kennethgrau/CAST_BACKUP/README.md

# CAST_BACKUP
This is a proper backup for the CAST capstone repository created by the software guys.

This repository contains software (C++ & Python) and hardware design files for the CAST Project.

### Visit the [CAST Google Drive](https://drive.google.com/drive/folders/1zKrm8BXflb28vrKOYb7QlBGXoKk1sI_n?usp=sharing)
## Cast Robot:
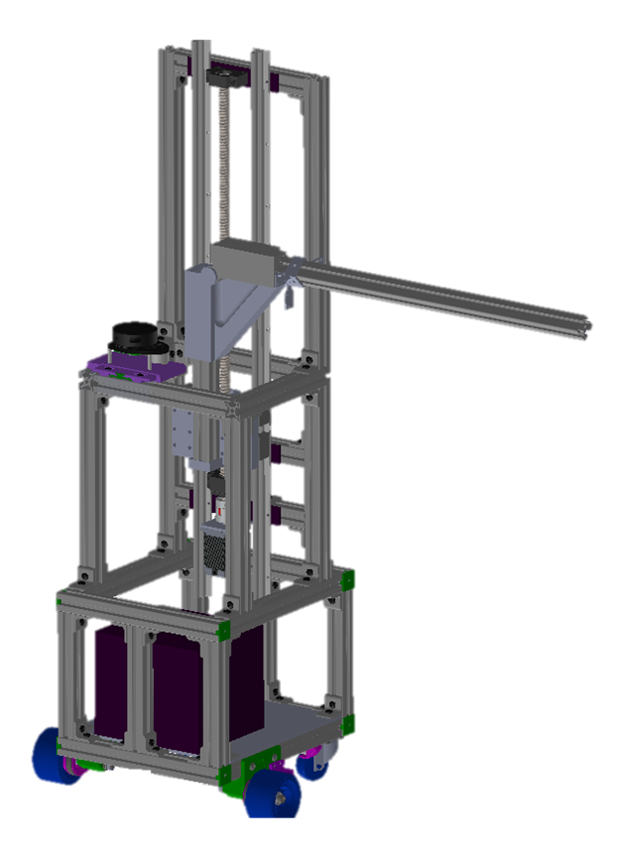
[picture p1: docs/photos&videos/index_files/Picture1.png]
CAST Robot


## Executive Summary
Our covid sanitization robot will bridge the gap between the need for clean surfaces and the lack of workforce brought about by different circumstances. Our robot will utilize a gamepad controller to move and Lidar as an early warning system of moving obstacles. To sanitize surfaces, we have a robotic arm equipped with UV lights that kill bacteria upon exposure and three time of flight sensors that will take in proximity data and maintain a safe distance between the arm and the surface to be cleaned. 

To allow the user to test the effectiveness of the robot we are also creating a bacteria killed indicator. This indicator uses a UV sensor to measure the amount of UV C radiation absorbed by the area and has the capabilities to communicate using IOT. By incorporating this product, we are giving the user an ability to test the effectiveness of the robot, this will be useful for error detection. 

By incorporating lidar into our design we’re paving the way for the robot to be fully autonomous in the future, removing the need for the gamepad controller. With a fully autonomous robot the design will be able to clean a small area without human interaction.

## Special Thanks
The team would like to start off by thanking everyone that has helped us get to this point in our project. Specifically, Dr. Biswas, David Malawey, Donald Bowen, Brey Carawey, Jorge Roa, Ricardo Castillo, Matthew Hammond, and Dr. Crosby. We’d also like to extend our thanks to the Texas A&M ETID department for the time and funding put into ensuring we had all the resources we needed to complete this project.

## License
This work is licensed under the Creative Commons Attribution-ShareAlike 4.0 License. To view details visit [creativecommons.org](https://creativecommons.org/licenses/by-sa/4.0/legalcode)
