kennethgrau/CAST_BACKUP/hardware/README.md

# CAST Hardware
This directory contains zipped gerber files, CAD models, and other hardware information.

### More hardware information can be found [here](https://drive.google.com/drive/folders/1Sd6P2nbnLkVIloje-kZ2ATfiy8y1uPqs?usp=sharing).
