kennethgrau/CAST_BACKUP/docs/supplemental/CAST BillofMaterials.pdf

# Project System | Item Name | Item Description | Source | Datasheet | Quantity | Unit | Price | Cost | Notes | PO | Approval | Fulfilled | Total | Budget remaining

1 Movement | SCUTTLE | SCUTTLE Robot Kit v2.3 | https://scuttlerobot.org/https://scuttlerobot.org/resources 1 | | | ea | $519.99 | $519.99 | | | DM | Yes | $3,063.94 | $1,936
2 | Movement | RPLidar A1M8 | RPLidar A1M8 (Changed from RPLidar s2) | https://www.adafruit.com/product/4010 https://cdn-shop.adafruit.com/product-files/4010/4010_datasheet.pdf 1 | ea | $99.95 | $99.95 | DM | Yes 3 | Movement | LifePO Battery | Ampere Time 12V 50Ah LiFePO4 Battery with 14.6V 10A Dedicated Lithium Battery Charger; Built-in 50A BMS, 4000+ Cycles, for Bass Boats, Trolling Motors, Monitoring Device, RV, Solar application… https://www.amazon.com/Ampere-Time-Dedicated-Monitoring-application/dp/B09DYTRYQL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 1 | ea | $314.99 | $314.99 | Yes | Totals 5 | Movement | USB A to Micro-B | USB Cable for connecting Lidar to Raspberry Pi | https://www.amazon.com/AmazonBasics-Male-Micro-Cable-Black/dp/B07232M876?th=1 1 | ea | $5.71 | $5.71 | DM | Yes | Budget | $5,000
6 | Infrastructure | T-Slotted Framing Rails | Size - T-Slotted Framing Rails | https://www.mcmaster.com/metals/structural-framing/t-slotted-framing-rails/ 40 | ft | $8.00 | $320.00 | Estimated | -please use automationdirect.com for better price 7 | Infrastructure | T-Slotted Corner Bracket | T-Slotted Corner Bracket for Single Rails (fasteners included) | https://www.mcmaster.com/80%2F20-compatible-t-slotted-framing/t-slotted-framing-structural-brackets/ 75 | ea | $3.40 | $255.00 | Estimated (find these on amazon for better value) | please match SCTL brackets & buy necessary fasteners, or 3D Print if you need a larger bracket 8 | Sanitizing Arm | T-Slotted Framing Rails | Size - T-Slotted Framing Rails | https://www.mcmaster.com/metals/structural-framing/t-slotted-framing-rails/ 2 | ft | $8.00 | $16.00 | please use automationdirect | Yes 9 | Sanitizing Arm | UV Diode (Old Diode) | L944-UV265-3 | https://www.digikey.com/en/products/detail/american-opto-plus-led/L944-UV265-3/12088431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 https://www.aopled.com/AOP_PDFs/L944-UV265-3.pdf 0 | ea | $25.00 | $0.00 | Already have | DM | Yes 10 | Sanitizing Arm | UV Diode (New Diode) | IN-C40PU(X)TK UVC | https://www.mouser.com/ProductDetail/Inolux/IN-C40PUBTKU1?qs=zW32dvEIR3sNPH03MBtbqA%3D%3D https://www.mouser.com/datasheet/2/180/IN_C40PU_X_TK_UVC_Series_V1_0-1919562.pdf 20 | ea | $25.67 | $513.40 | DM | Yes 11 | Sanitizing Arm | SM Relay Hat | Relay Hat to control UV lights | SM Relay HAT | 1 | ea | $45.00 | $45 | No longer considering | This relay hat will block airflow to your processor, also relays are much cheaper. 12 | Sanitizing Arm | NOYITO SSR Relay | 2 channel, 12V SSR relay to control UV lights | NOYITO Relay | 1 | ea | $8.50 | $8.50
13 | Sanitizing Arm | SSR-25DD | DC to DC Relay | SSR-25DD (https://www.amazon.com/SSR-100DD-3-32VDC-Output-5-240VDC-Plastic/dp/B08GNSPCND) | 1 | ea | $9.90 | $9.90 | DM | Yes 14 | Sanitizing Arm | LM2596 | Buck Voltage Step Down Converter for UV Lights | LM2596 | 1 | ea | $7.39 | $7.39 | DM | Yes 15 | Sanitizing Arm | PCB for LED Array | Possible redesign of PCB for space and heat | JCL PCB | 8 | ea | $1.45 | $32.00 | Shipping brought total to $18.10 | DM | Yes 16 | Sanitizing Arm | Heatsinks for PCBs | 100x25x10mm Aluminum Heatsink | https://www.amazon.com/Nxtop-Aluminium-Radiator-Heatsink-100x25x10mm/dp/B07D9ZTTN2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 2 | pkg | $8.59 | $17.18 | Order 1 pack when PCB is ordered to test | DM | Yes 17 | Sanitizing Arm | VL53L0X | VL53L0X Time of flight distance sensor | https://www.adafruit.com/product/3317 https://cdn-learn.adafruit.com/assets/assets/000/037/547/original/en.DM00279086.pdf 3 | ea | $14.95 | $44.85 | DM | Yes 18 | Sanitizing Arm | Linear Actuator with NEMA | Actuator with NEMA Motor to Raise and Lower Arm | https://www.amazon.com/FUYU-Linear-Actuator-Motorized-Stepper/dp/B077QD97SW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 https://www.amazon.com/FUYU-Linear-Actuator-Motorized-Stepper/dp/B077QD97SW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 1 | ea | $232.00 | $232.00 | No Longer Considering 19 | Sanitizing Arm | Linear Actuator | Actuator to Raise and Lower Arm | https://www.aliexpress.com/item/4000550535417.html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,scm-url:1007.33416.213724.0,pvid:0f2d5d8e-258a-49d5-a682-23b35eb8d913,tpp_buckets:668%232846%238108%231977&&pdp_ext_f=%7B%22sceneId%22:%2223416%22,%22sku_id%22:%2210000010481784666%22%7D&compareFields=formatted_price:US%20$65.00;itemId:4000550535417;freight_formatted_price:null;source:recommend-sku;is_freeshipping:null;trade_order:53 1 | ea | $135.00 | No Longer Considering | DM | N/A
20 Sanitizing Arm | DRV8825 | NEMA Motor Driver | https://www.pololu.com/product/2133/specs https://www.ti.com/lit/ds/symlink/drv8825.pdf?ts=1644532071243&ref_url=https%253A%252F%252Fwww.google.com%252F 1 | ea | $18.95 | $18.95 | No Longer Condidering
21 | Sanitizing Arm | ST-M5045 | NEMA Step Motor Driver | ST-M5045 Driver (https://www.sainsmart.com/products/cnc-4-5a-micro-stepping-stepper-motor-driver) | ST-M5045 Datasheet (http://s3.amazonaws.com/s3.image.smart/download/101-80-109/2-Phase_stepper_Motor_Driver_ST-M5045.pdf) | 1 | ea | $0.00 | $0.00 | Already have | DM | Yes 22 | Sanitizing Arm | CNCCANEN Ball Screw | Ball screw assembly (700mm) | Ball Screw Assembly | 1 | ea | $61.58 | $61.58 | DM | Yes 23 | Sanitizing Arm | Linear Rail Guides | Side rails for additional support (800 mm) | Linear Rail Guides | 1 | ea | $72.89 | $72.89 | DM | Yes 24 | Sanitizing Arm | McMaster NEMA 23 Motor | McMaster NEMA 23 Motor | McMaster NEMA 23 | 1 | ea | $128.53 | $128.53 | No longer considering | let's replace with a digikey part 25 | Sanitizing Arm | Digikey NEMA 23 Motor | Digikey NEMA 23 Motor | Digikey NEMA 23 | 1 | ea | $68.73 | $68.73 | DM | Yes 26 | Sanitizing Arm | Ball Screw Nut | Second Ball Screw Nut for Arm Stability (SFU1605) | Ball Screw Nut | 1 | ea | $21.89 | $21.89 | DM | Yes 27 | Sanitizing Arm | Ball Screw Nut Bracket | Second Ball Screw Nut Bracket for Arm Stability (Dia 28mm) | Ball Screw Bracket | 1 | ea | $10.99 | $10.99 | DM | Yes 28 | Sanitizing Arm | 12V to 24V Converter | 12V 24V 2A Step-Up Converter | https://www.amazon.com/12V-Converter-Transformer-Regulator-Waterproof/dp/B0922FVBTD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 1 | ea | $14.48 | $14.48 | No longer considering | Please increase spec for more amperage. 29 | Sanitizing Arm | 12V to 24V Converter | Supernight 12V to 24V Converter | Supernight Step Up | 1 | ea | $18.98 | $18.98 | DM | Yes 30 | Sanitizing Arm | UV Safety Goggles | Safety goggles for testing | https://www.amazon.com/Tool-Klean-Safety-Glasses-Protection/dp/B081BHTJT8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 6 | ea | $16.95 | $101.70 | DM | Yes 31 | Sanitizing Arm | Mechanical Limit Switches | Limit switches for actuator to support software stop | https://www.amazon.com/REIFENG-Mechanical-Endstop-Switch-Arduino/dp/B07TWKH7F7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 1 | ea | $11.99 | $11.99 | Pack of 10 with cables (best value) | DM | Yes 32 | Sensor | Wemos d1 esp-wroom-02 | Wemos Microcontroller with 18650 Battery Holder Attached | https://www.aliexpress.com/item/1005003407217669.html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 1 | ea | $4.08 | $4.08 | https://drive.google.com/drive/u/2/folders/1UXeFPIUDJNAMe-tF8xKlrGVcdVFR-mCo | Yes 33 | Sensor | 18650 LiPo Battery | 3.7 V LiPo Battery | https://www.18650batterystore.com/collections/18650-batteries/products/samsung-35e 1 | ea | $7.99 | $7.99 | https://drive.google.com/drive/u/2/folders/1UXeFPIUDJNAMe-tF8xKlrGVcdVFR-mCo Please find a LiPo as requested last semester | Yes 34 | Sensor | UV Light Sensor | UV Intensity Sensor on Breakout Board | https://www.adafruit.com/product/1918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 https://cdn-shop.adafruit.com/datasheets/1918guva.pdf 1 | ea | $12.40 | $12.40 | https://drive.google.com/drive/u/2/folders/1UXeFPIUDJNAMe-tF8xKlrGVcdVFR-mCo DM | Yes 35 | Sensor | 3D Printed Housing | Designed Housing for sensor components | https://engineering.tamu.edu/academics/fedc/facility/prototype-center.html 1 | ea | $15.00 | $15.00 | DM
36 All | Assorted Wiring | Assorted 22AWG wiring for componenets (pack) | 1 | ea | $16.95 | $16.95 | Pack of spools | DM
37 All | Assorted Connectors | Assorted Dupont jumper connectors (pack) | 1 | ea | $14.95 | $14.95 | Pack of assorted connectors | DM
38 All | Wire ties / Snakeskin | Cable management items | 1 | ea | $20.00 | $20.00 | Assorted | DM
