kennethgrau/CAST_BACKUP/hardware/3D_Prints/README.md

# CAST 3D Prints
Updated 2022.5.2

## Find native SOLIDWORKS & STEP files on grabCAD
https://grabcad.com/library/cast-robot-v16-2022-1
