kennethgrau/CAST_BACKUP/docs/supplemental/CAST WiringGuide.pdf

# CAST Robot Wiring Guide

# CAST Bot Contains one CPU

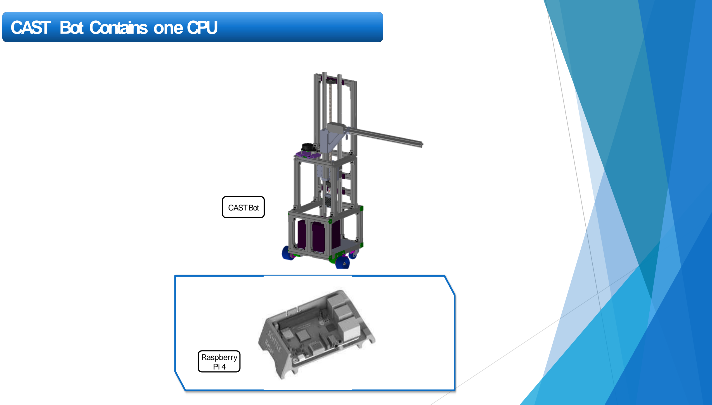
[picture p2: page 2]

Raspberry
Pi 4

CAST Bot

# CAST WiringFor Raspberry Pi 4

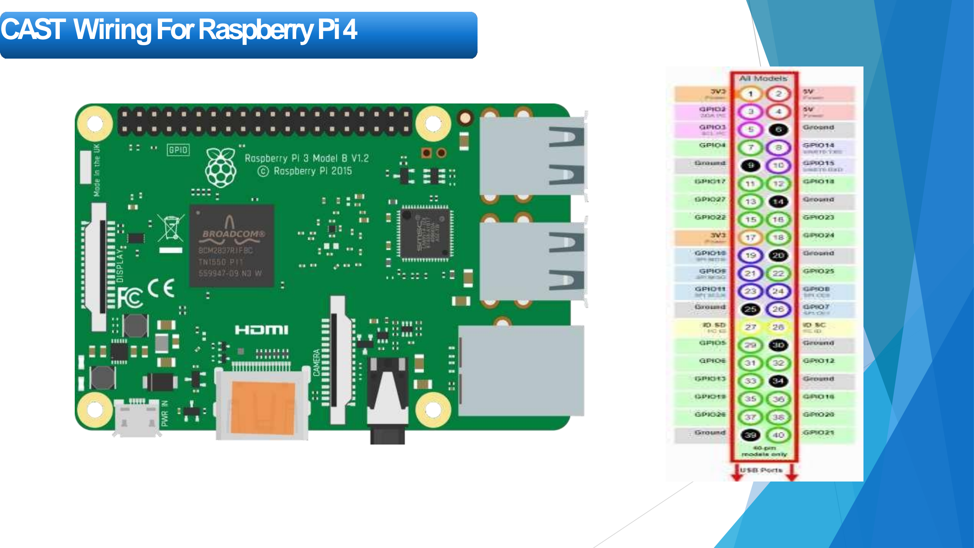
[picture p3: page 3]

# Validated Sensors & Actuators

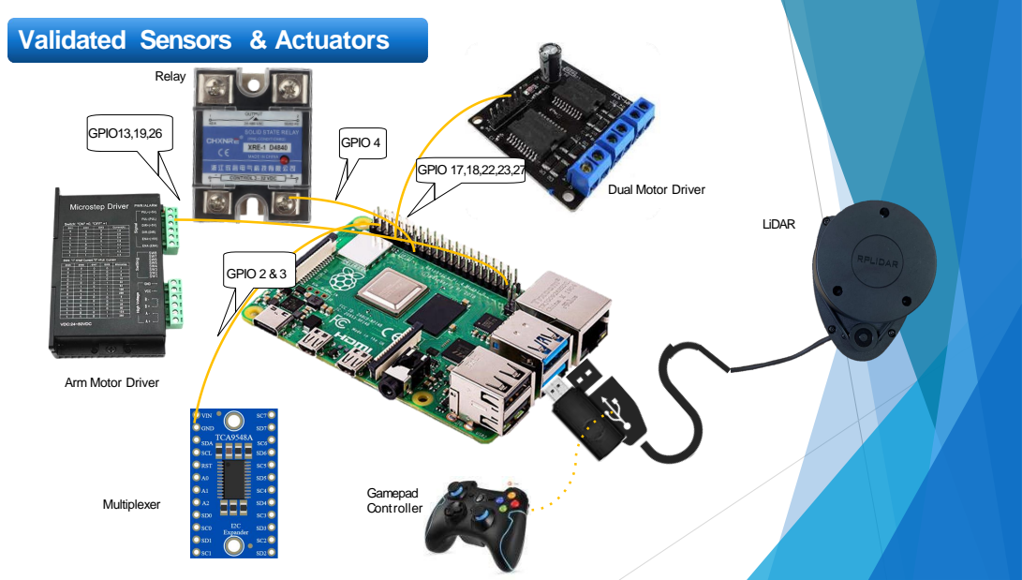
[picture p4: page 4]
LiDAR; Relay; Multiplexer; GPIO13,19,26; GPIO 4; GPIO 2 & 3; Gamepad Controller; GPIO 17,18,22,23,27

Dual Motor Driver

Arm Motor Driver

# Pi - Power Supply

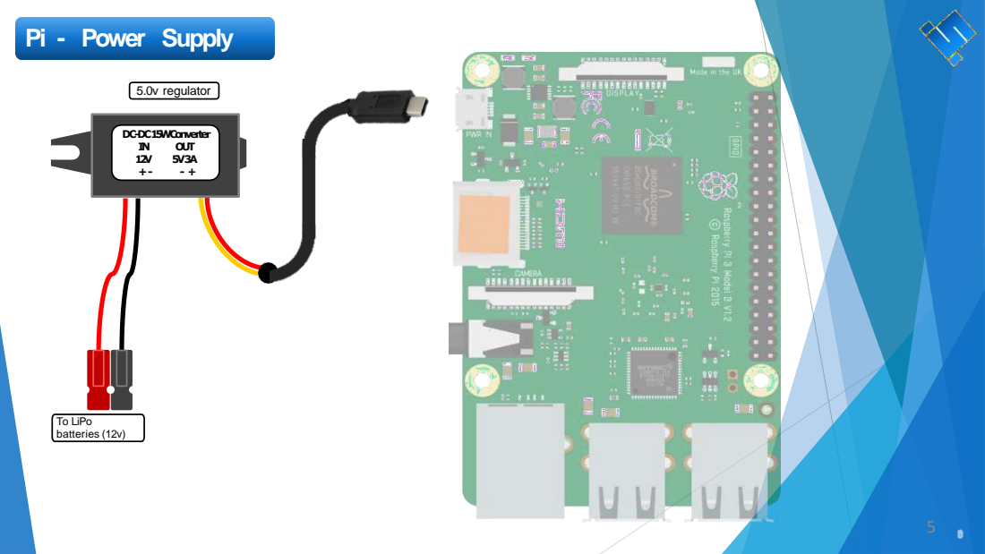
[picture p5: page 5]
To LiPo batteries (12v); 5.0v regulator; OUT

DC-DC 15W Converter

# Pi - Motor Driver Signals

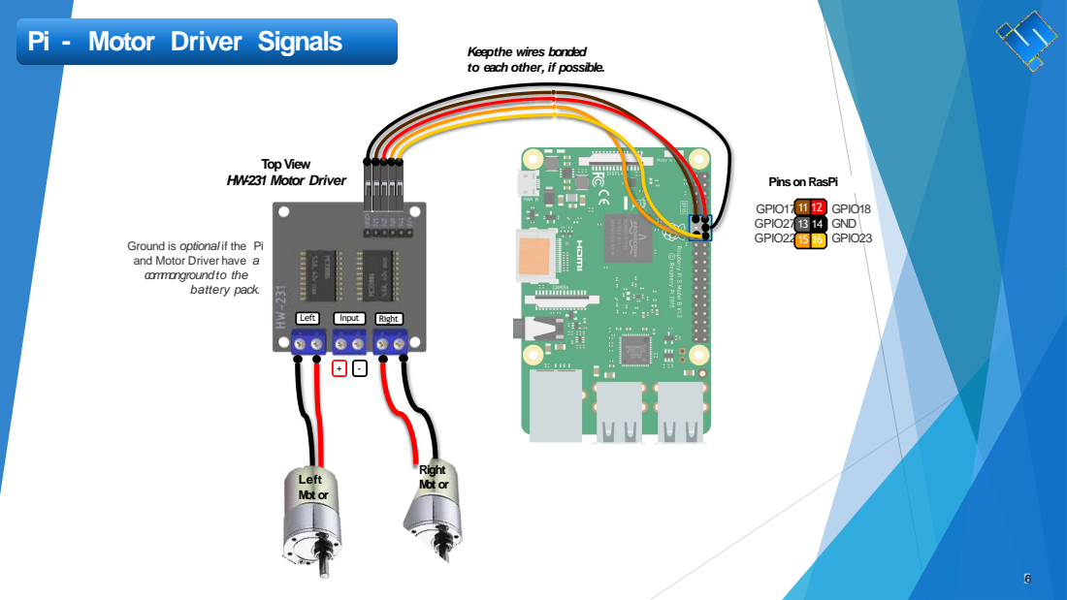
[picture p6: page 6]
Left; Input; Right; Right Mot or; Left Mot or; GPIO18 GND GPIO23; GPIO17 11 12 GPIO27 13 14 GPIO22 15 16; battery pack.

Keep the wires bonded
to each other, if possible.

TopView
HW-231 Motor Driver

Pins on RasPi

Ground is optional if the Pi
and Motor Driver have a
common ground to the

# PI - Stepper Driver - ST-M5045

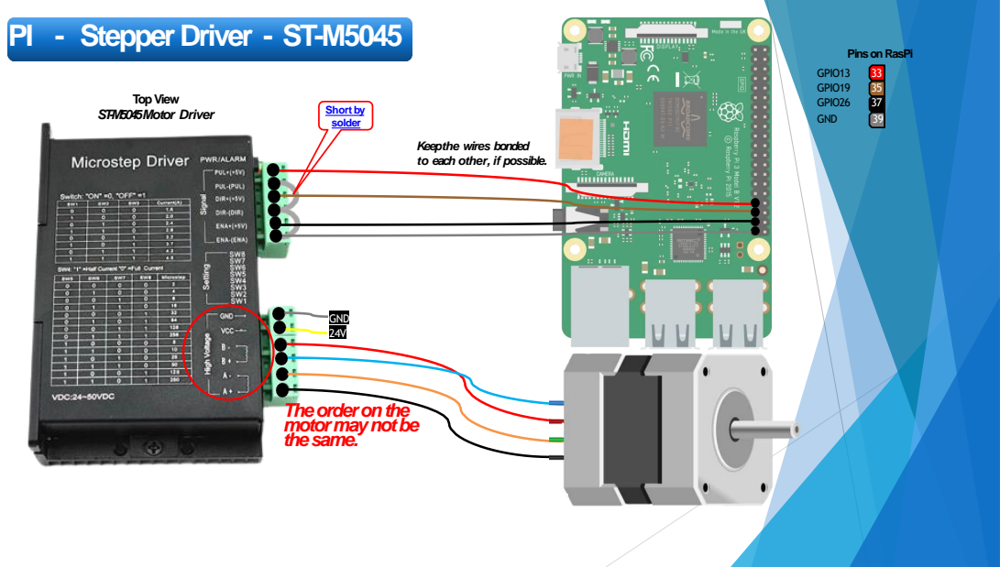
[picture p7: page 7]
GPIO13; GPIO19; GPIO26; GND; GND 24V; TopView; ST-M5045 Motor Driver; Short by; solder

Pins on RasPi

Keep the wires bonded
to each other, if possible.

The order on the
motor may not be
the same.

# PI - Multiplexer –TCA9548A

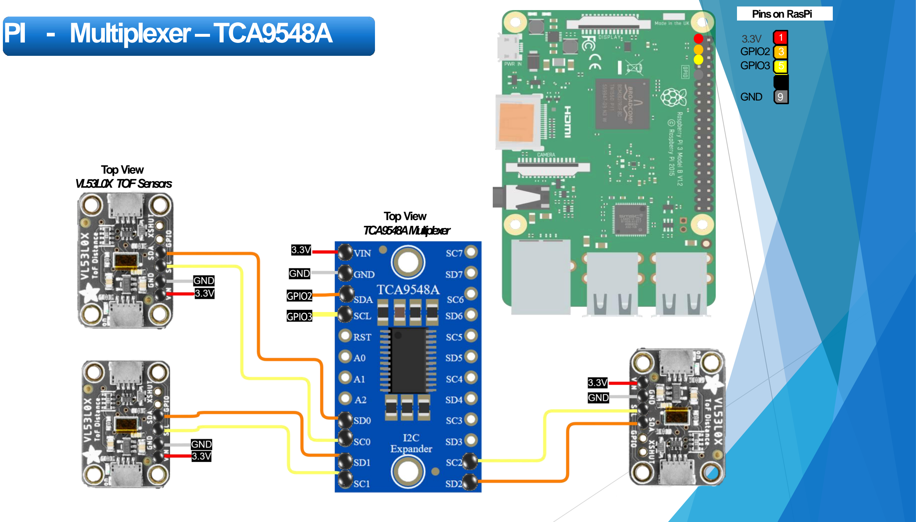
[picture p8: page 8]

Pins on RasPi

3.3V 1
GPIO2 3
GPIO3 5

GND 9

GPIO2

GPIO3

TopView
TCA9548AMultiplexer

TopView
VL53L0X TOF Sensors

# PI - RPLiDAR and Gamepad

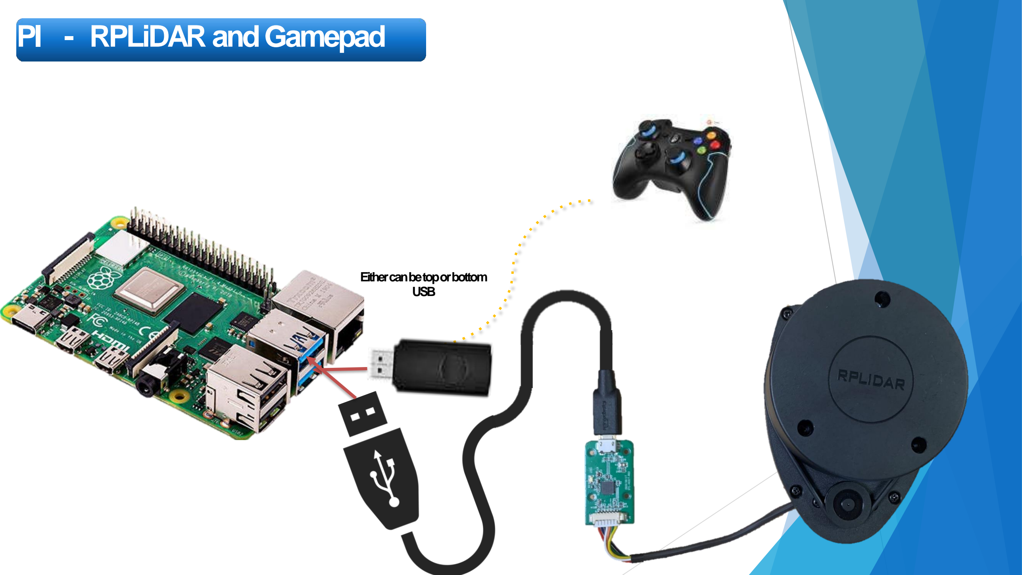
[picture p9: page 9]

Either can be top or bottom USB

# LiPo Battery–Step Up & Step Down

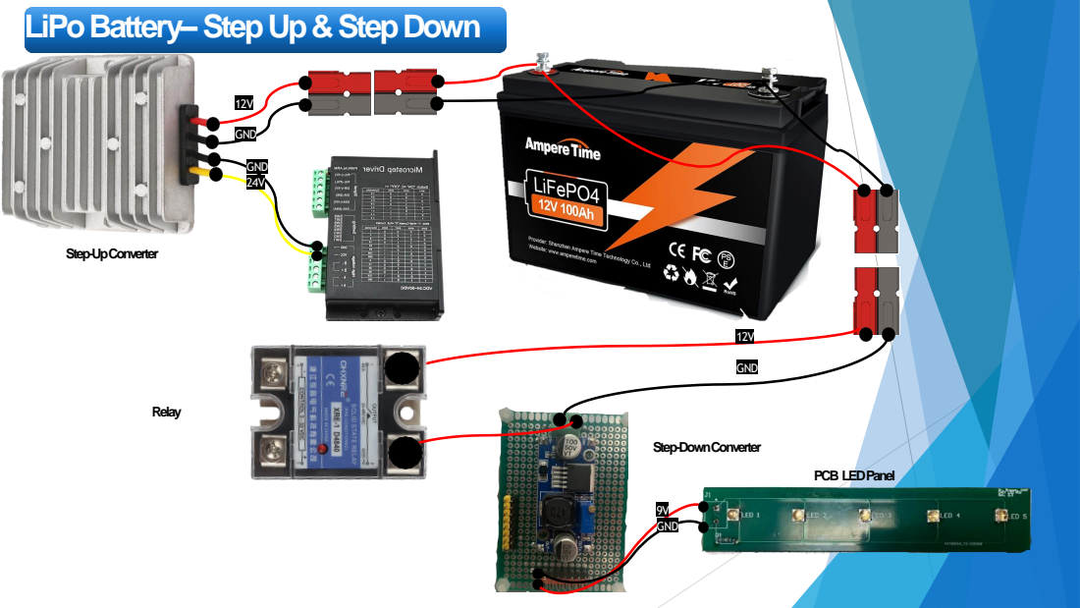
[picture p10: page 10]
GND 24V; GND; 9V GND; Relay

Step-Up Converter

Step-Down Converter

PCB LED Panel

# Bacteria Killed Indicator Wiring Guide

# Bacteria Killed Indicator Contains one CPU

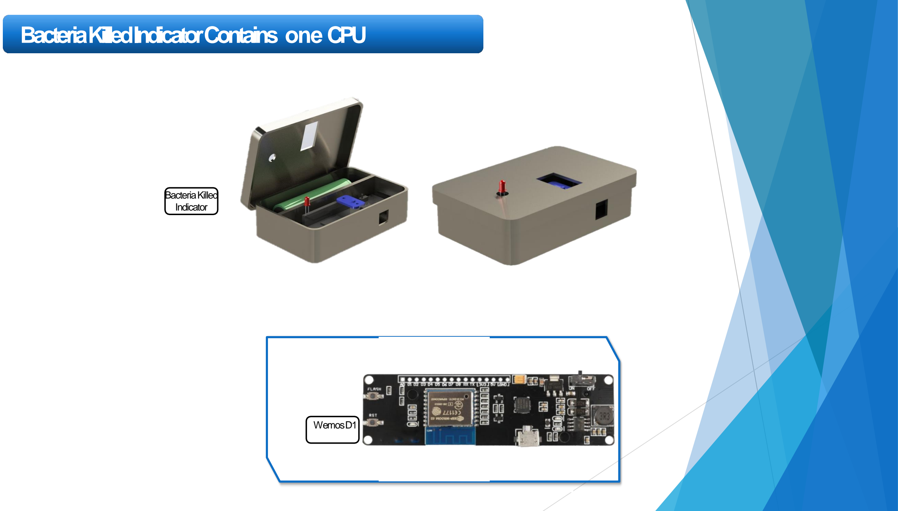
[picture p11: page 12]

Bacteria Killed
Indicator

WemosD1

# WemosD1 -Wiring

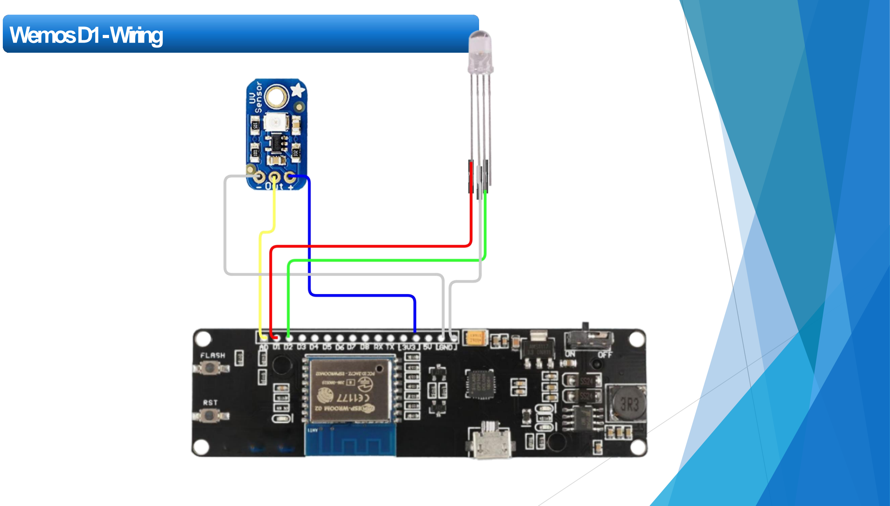
[picture p12: page 13]
