kennethgrau/CAST_BACKUP/software/L3_obstacleAvoid.py

# This program includes the obstacle avoidance protocols for CAST robot
# Includes the use of ToF sensors to check planes of arm for obstacles
# similar to how a garage door detects objects.
# This provides automatic control of the arm. Manual control is available in
# L3_gpControl.py
# Updated 4/20/2022 - Kenneth Grau

# Import external libraries
import time
import board
import busio
import pigpio

# Import internal libraries
import L1_actuator as act
import L1_distSensor as ToF
import L1_multiplexor as mult

pi = pigpio.pi()

botEndStop = 6

pi.set_mode(botEndStop, pigpio.INPUT)       # enable pin (active low)

# Create I2C bus as normal 
i2c = busio.I2C(board.SCL, board.SDA)
time.sleep(0.5)

# Create TCA9548A object
tca = mult.TCA9548A(i2c)
time.sleep(0.5)

# Initialize distance sesnor objects
botToF = ToF.VL53L0X(tca[6])
rightToF = ToF.VL53L0X(tca[7])
time.sleep(0.5)

# Variable to quickly update arm length if hardware change occurs
arm = 559

def go():
    while (1):
        if (rightToF.range < arm):
            # print('obstacle detected in path of arm')
            act.sendPWM(1,0.09)
            while (rightToF.range < arm):
                print("moving arm up, movement disabled")
                time.sleep(0.2)
            act.sendPWM(1,0)
        if botToF.range > arm:
            act.sendPWM(0,0.09)
            while(botToF.range > arm and rightToF.range > arm):
                print('moving down')
                time.sleep(0.2)
        else:
            act.sendPWM(0,0)
            time.sleep(0.2)
            
        
        

if __name__ == "__main__":
    go()
        
    
