kennethgrau/CAST_BACKUP/(commit log)

2022-04-13 Tested with actuator and made adjustments for speed
2022-04-14 Scrubbed some lidar code and som research on the library used
2022-04-22 Solved actuator problems
2022-04-30 Delete Lidar_and_LED.py
    Removed unneeded software
2022-05-02 Added relevant datasheets and gerber files
2022-05-02 Added BOM
    [Bill of Materials.xlsx]
